hsetlik/EnvFilterPedal/Simulations/mc34063_sim.asc

C1: polcap; 220µ
C2: cap; 470p
C3: polcap; 470µ
C4: polcap; 220µ
D1: schottky; RB050LAM-30
L1: ind; 68µ
L2: ind; 4.7µ
R1: res; 0.24
R2: res; 8k2
R3: res; 51k
R4: res; 90
U2: mc34063
V2: battery; 9
Named nets: 0, -9a, -9b
.tran 40m startup
.inc mc34063.lib
