hsetlik/EnvFilterPedal/Simulations/LadderFilterSim.asc

C1: cap; 47n
C2: cap; 47n
C3: cap; 47n
C4: cap; 47n
C5: cap; 220µ
C6: polcap; 10µ
C7: cap; 10µ
C8: cap; 1µ
C9: cap; 22µ
Q1: npn; BC547B
Q2: npn; BC547B
Q3: npn; BC547B
Q4: npn; BC547B
Q5: npn; BC547B
Q6: npn; BC547B
Q7: npn; BC547B
Q8: npn; BC547B
Q9: npn; BC547B
Q10: npn; BC547B
Q11: npn; BC547B
Q12: pnp; BC557C
R1: res; 220
R2: res; 220
R3: res; 220
R4: res; 220
R5: res; 220
R6: res; 220
R7: res; 470
R8: res; 100k
R9: res; 100k
R10: res; 470
R11: res; 470k
R12: res; 470k
R13: res; 100k
R14: res; 100k
R15: res; 5k
R16: res; 5k
R17: res; 100k
R18: res; 100k
R19: res; 470k
R20: res; 1k
R21: res; 100k
R22: res; 100k
R23: res; 680
R24: res; 2k
R25: res; 8k
R26: res; 47k
R27: res; 470
R28: res; 1k8
R29: res; 100k
R30: res; 470k
R31: res; 22k
R32: res; 3k
R33: res; 7k
R34: res; 100k
U1: LT1058
U2: LT1058
U3: LT1058
U4: LT1058
U5: LT1058
U6: LT1058
V1: voltage; PULSE(-200mv 200mv 0 100u 100u 2m 4m)
V2: voltage; 9
V4: voltage; PULSE(3.3 0 500m 10m 60m 30m 100m 1)
Named nets: +9, 0, env, GTR, vg, b1, b2, b3, b4, b5
.tran 0 600m 500m
.lib lm13700.sub
R15 & 16 = 10k resonance control
NOTE: this is inverting to the env. attenuverter
should be wired in reverse to match
