hsetlik/EnvFilterPedal/Simulations/EnvFollowerRev2.asc

C1: cap; 470n
C2: cap; 4.7n
C3: cap; 1µ
C4: cap; 100n
C5: cap; 1µ
C6: cap; 10n
D1: diode; 1N4148
D2: diode; 1N4148
D3: diode; 1N4148
D4: LED
Q1: pnp; BC857A
Q2: pnp; BC857A
Q3: npn; BC847A
R1: res; 4.7k
R2: res; 100k
R3: res; 680
R4: res; 680
R5: res; 4.7k
R6: res; 91k
R7: res; 2k7
R8: res; 470k
R9: res; 22k
R10: res; 1Meg
R11: res; 100k
R12: res; 100k
R13: res; 100k
R14: res; 50k
R15: res; 1k
R16: res; 100k
R17: res; 22k
R18: res; 100k
R19: res; 100k
R20: res; 6k8
R21: res; 1k8
R28: res; 47k
R29: res; 12k
U1: LM13700
U2: LT1058
U3: LT1058
U4: LT1058
U5: LT1058
U6: LT1058
U7: LT1058
U8: LT1058
U11: LT1058
V1: voltage; SINE(0 0.1 440)
V2: voltage; 9
V3: voltage; 9
V4: voltage; PULSE(0 3.3 0 10m 60m 30m 100m 1)
V5: voltage; 5
Named nets: 0, +9, -9, GTR, vcc, GTR_GAIN, FullRect
.tran 200m UIC
.INCLUDE CD4000.lib
.INCLUDE 74HC.lib
.lib lm13700.sub
Ignore this it's just a convenient way to simulate a guitar signal
