hsetlik/EnvFilterPedal/Simulations/FilterType2.asc

C1: cap; 470n
C2: cap; 470n
C5: cap; 4.7n
C6: cap; 1n
C7: cap; 470n
C8: cap; 1n
C9: cap; 470n
C10: cap; 1n
C11: cap; 1n
C12: cap; 470n
C13: cap; 470n
D3: diode; 1N4148
D4: diode; 1N4148
Q3: pnp; BC857A
Q4: pnp; BC857A
R1: res; 47k
R2: res; 47k
R3: res; 50k
R4: res; 50k
R5: res; 33k
R6: res; 33k
R7: res; 100k
R8: res; 10k
R9: res; 10k
R10: res; 5k
R11: res; 5k
R22: res; 33k
R23: res; 680
R24: res; 680
R25: res; 4.7k
R26: res; 100k
R27: res; 2.2k
R28: res; 470k
R29: res; 33k
R30: res; 680
R31: res; 680
R32: res; 33k
R33: res; 33k
R34: res; 80k
R35: res; 20k
R36: res; 10k
R37: res; 1.8k
R38: res; 4.7k
R39: res; 4.7k
R40: res; 100k
R41: res; 7k
R42: res; 3k
R43: res; 22k
R44: res; 22k
R45: res; 680
R46: res; 680
R47: res; 33k
R48: res; 22k
R49: res; 4.7k
R53: res; 680
R54: res; 680
R55: res; 33k
R56: res; 22k
R57: res; 4.7k
U1: LT1058
U2: LT1058
U7: LM13700
U8: LT1058
U9: LM13700
U10: LM13700
U12: LT1058
U13: LM13700
V1: voltage; PULSE(-200mv 200mv 0 200u 200u 3m 6m)
V2: voltage; 9
V3: voltage; 9
V4: voltage; PULSE(0 3.3 20m 10m 60m 30m 100m 1)
Named nets: +9, -9, 0, env, GTR, ENV, LP_CONS, IABC, HP_CONS, SUM
.tran 200m UIC
.lib lm13700.sub
Ignore this it's just a convenient way to simulate a guitar signal
R41 & 42 = 10k frequency control
R3 & R4 = 100k blend control
R10 & 11 = 10k depth control
