hsetlik/EnvFilterPedal/Simulations/EnvFollowerSim.asc

C1: cap; 470n
C2: cap; 4.7n
C3: cap; 10n
C5: cap; 100n
C6: cap; 1µ
D9: diode; 1N4148
D10: diode; 1N4148
D11: diode; 1N4148
D12: diode; 1N4148
Q1: pnp; BC857A
Q2: pnp; BC857A
R1: res; 4.7k
R2: res; 100k
R3: res; 680
R4: res; 680
R5: res; 4.7k
R6: res; 91k
R7: res; 2k7
R8: res; 470k
R9: res; 22k
R10: res; 100k
R16: res; 22k
R17: res; 47k
R18: res; 470
R19: res; 50k
R20: res; 100k
R21: res; 100k
R22: res; 820
R27: res; 22k
R28: res; 100k
R29: res; 22k
U1: LM13700
U2: LT1058
U3: LT1058
U8: LT1058
U9: LT1058
U10: LT1058
U11: LT1058
V1: voltage; SINE(0 0.1 440)
V2: voltage; 9
V3: voltage; 9
V4: voltage; PULSE(0 3.3 0 10m 60m 30m 100m 1)
V5: voltage; 5
Named nets: 0, +9, -9, GTR, vcc
.tran 200m UIC
.INCLUDE CD4000.lib
.INCLUDE 74HC.lib
.lib lm13700.sub
Ignore this it's just a convenient way to simulate a guitar signal
R19 = Sustain control 100k
