hsetlik/EnvFilterPedal/EnvFilterPedal.kicad_pcb

## KiCad design EnvFilterPedal.kicad_pcb (2026-07-02)

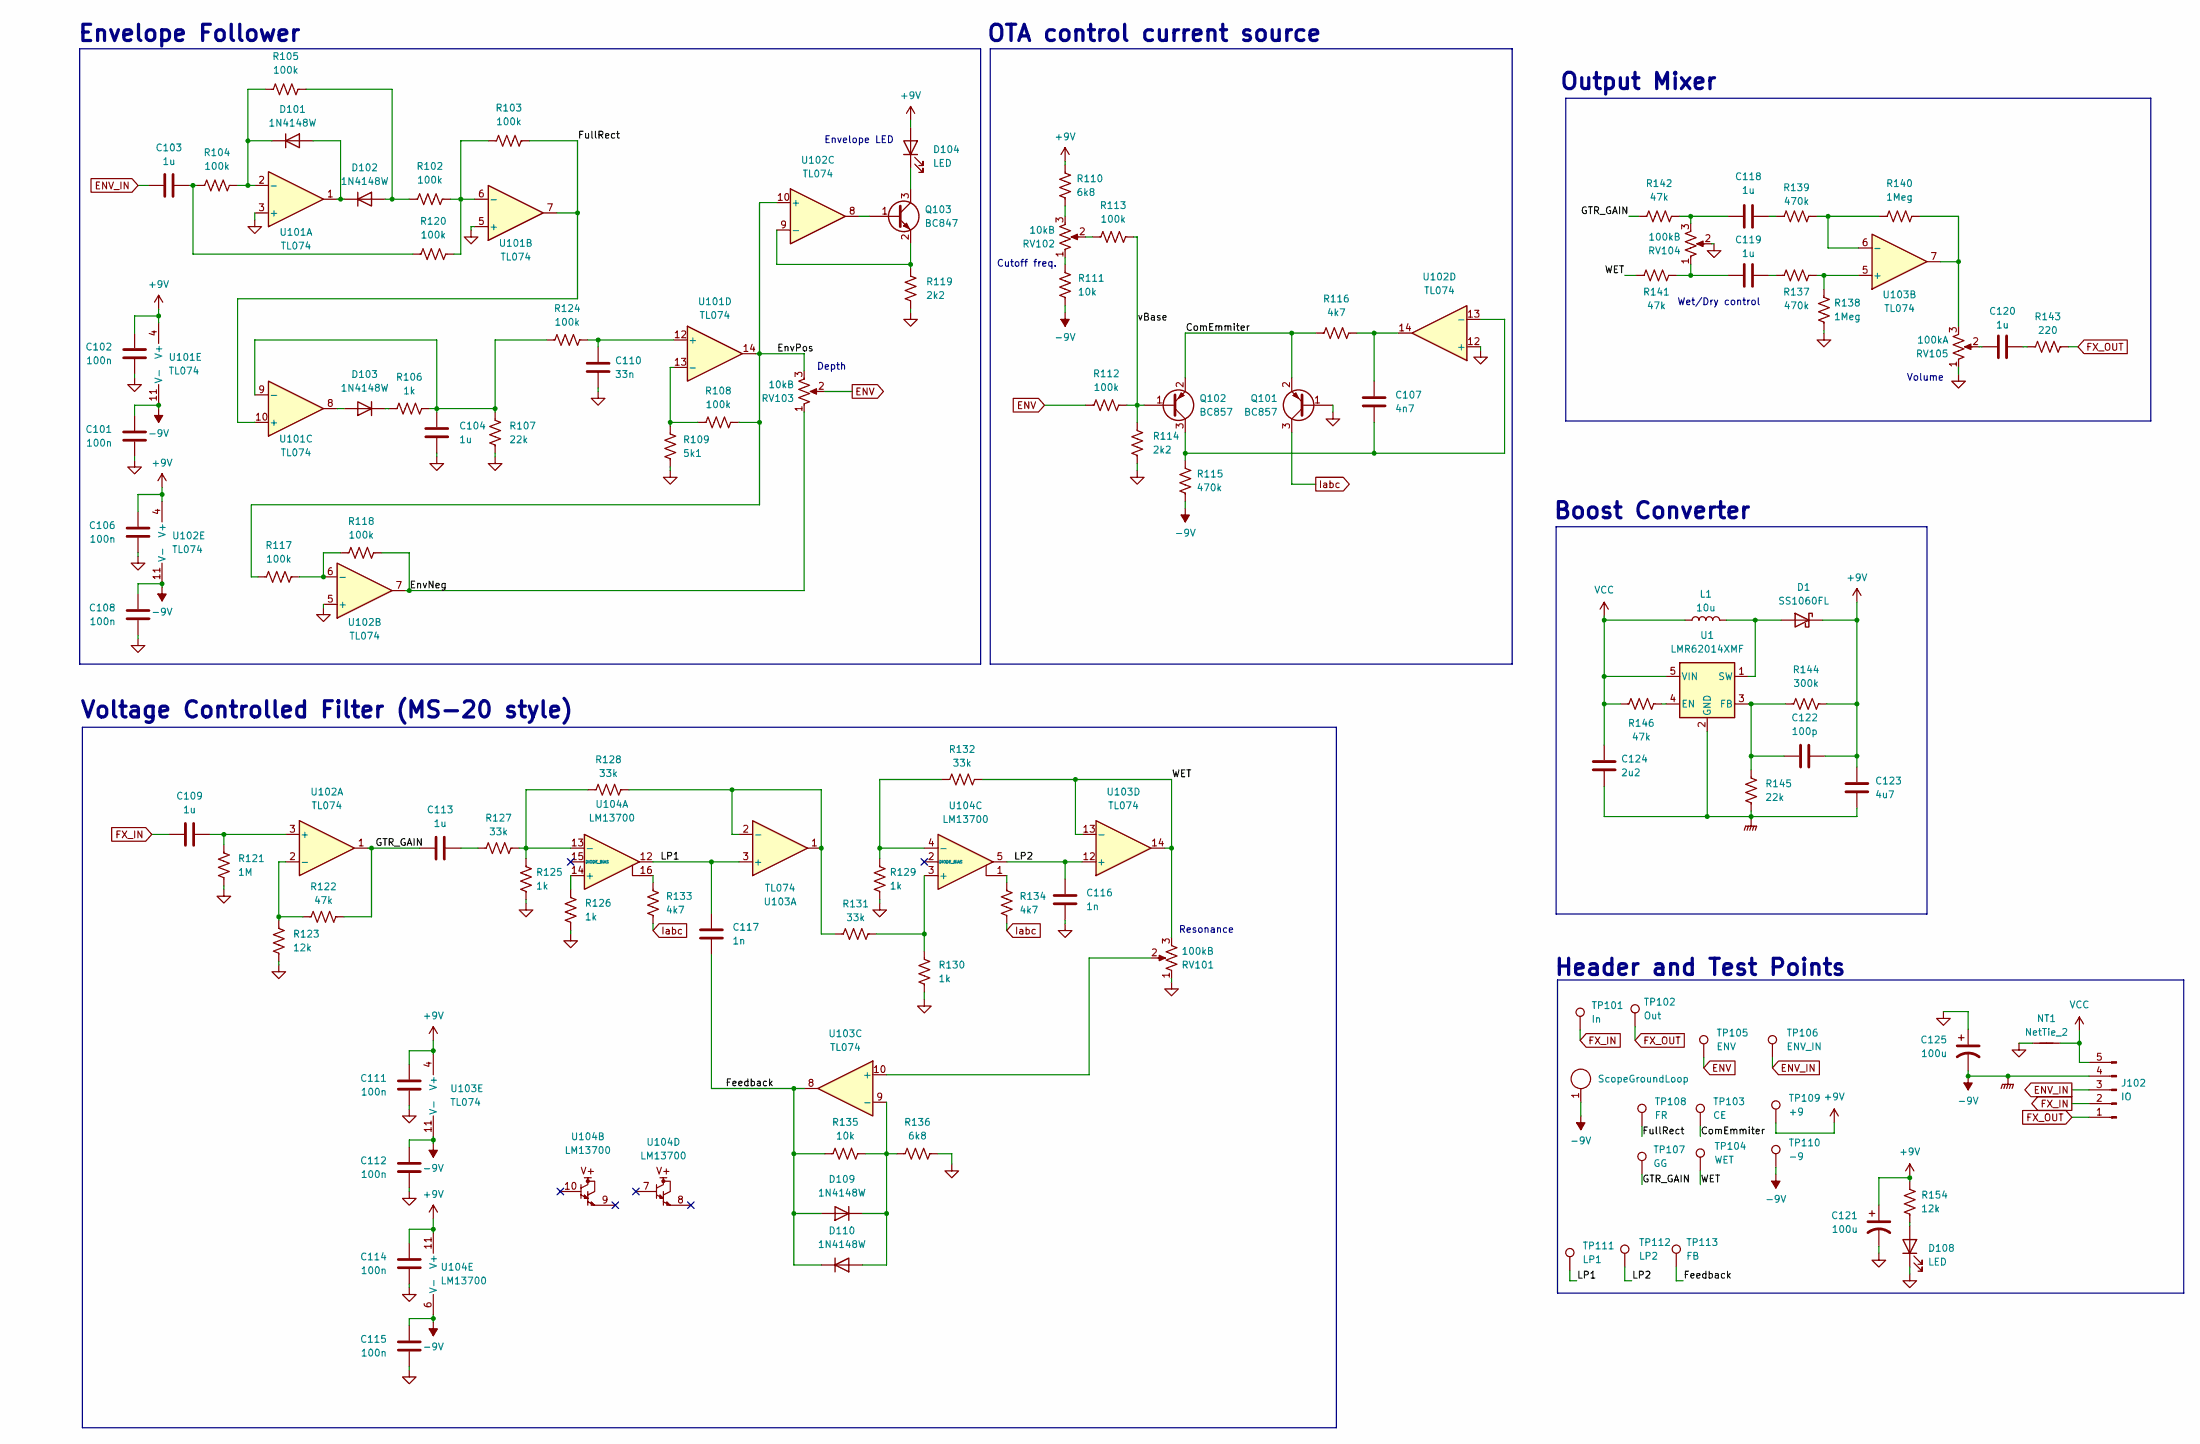
[picture p1: schematic EnvFilterPedal.kicad_sch]

Parts:
C101, C102, C106, C108, C111, C112, C114, C115: 100n; C_0805_2012Metric
C103, C104, C109, C113, C118, C119, C120: 1u; C_0805_2012Metric
C107: 4n7; C_0805_2012Metric
C110: 33n; C_0805_2012Metric
C116, C117: 1n; C_0805_2012Metric
C121, C125: 100u; CP_Radial_D5.0mm_P2.00mm
C122: 100p; C_0805_2012Metric
C123: 4u7; C_0805_2012Metric
C124: 2u2; C_0805_2012Metric
D1: SS1060FL; D_SOD-123F
D101, D102, D103, D109, D110: 1N4148W; D_SOD-123
D104, D108: LED; LED_D3.0mm
J101: ScopeGroundLoop; THT_GND_WIRE
J102: IO; PinHeader_1x05_P2.54mm_Vertical
L1: 10u; L_SigTransformer_SLPPI04_15
NT1: NetTie_2; NetTie-2_SMD_Pad0.5mm
Q101, Q102: BC857; SOT-23
Q103: BC847; SOT-23
R102, R103, R104, R105, R108, R112, R113, R117, R118, R120, R124: 100k; R_0805_2012Metric
R106, R125, R126, R129, R130: 1k; R_0805_2012Metric
R107, R145: 22k; R_0805_2012Metric
R109: 5k1; R_0805_2012Metric
R110, R136: 6k8; R_0805_2012Metric
R111, R135: 10k; R_0805_2012Metric
R114, R119: 2k2; R_0805_2012Metric
R115, R137, R139: 470k; R_0805_2012Metric
R116, R133, R134: 4k7; R_0805_2012Metric
R121: 1M; R_0805_2012Metric
R122, R141, R142, R146: 47k; R_0805_2012Metric
R123, R154: 12k; R_0805_2012Metric
R127, R128, R131, R132: 33k; R_0805_2012Metric
R138, R140: 1Meg; R_0805_2012Metric
R143: 220; R_0805_2012Metric
R144: 300k; R_0805_2012Metric
RV101, RV104: 100kB; Potentiometer_Alpha_RV16AF_42_VeryLong
RV102, RV103: 10kB; Potentiometer_Alpha_RV16AF_42_VeryLong
RV105: 100kA; Potentiometer_Alpha_RV16AF_42_VeryLong
TP101: In; TestPoint_THTPad_D2.0mm_Drill1.0mm_VAL
TP102: Out; TestPoint_THTPad_D2.0mm_Drill1.0mm_VAL
TP103: CE; TestPoint_THTPad_D2.0mm_Drill1.0mm_VAL
TP104: WET; TestPoint_THTPad_D2.0mm_Drill1.0mm_VAL
TP105: ENV; TestPoint_THTPad_D2.0mm_Drill1.0mm_VAL
TP106: ENV_IN; TestPoint_THTPad_D2.0mm_Drill1.0mm_VAL
TP107: GG; TestPoint_THTPad_D2.0mm_Drill1.0mm_VAL
TP108: FR; TestPoint_THTPad_D2.0mm_Drill1.0mm_VAL
TP109: +9; TestPoint_THTPad_D2.0mm_Drill1.0mm_VAL
TP110: -9; TestPoint_THTPad_D2.0mm_Drill1.0mm_VAL
TP111: LP1; TestPoint_THTPad_D2.0mm_Drill1.0mm_VAL
TP112: LP2; TestPoint_THTPad_D2.0mm_Drill1.0mm_VAL
TP113: FB; TestPoint_THTPad_D2.0mm_Drill1.0mm_VAL
U1: LMR62014XMF; SOT-23-5
U101, U102, U103: TL074; SOIC-14_3.9x8.7mm_P1.27mm
U104: LM13700; SOIC-16_3.9x9.9mm_P1.27mm

Connections:
+9V: C102.1, C106.1, C111.1, C114.1, C121.1, C122.2, C123.1, D1.1 (K), D104.2 (A), R110.1, R144.2, R154.1, TP109.1 (1_1), U101.4 (V+), U102.4 (V+), U103.4 (V+), U104.11 (V+)
-9V: C101.1, C108.1, C112.1, C115.1, C123.2, C124.2, C125.2, J101.1, J102.4, R111.2, R115.2, R145.1, TP110.1 (1_1), U1.2 (GND), U101.11 (V-), U102.11 (V-), U103.11 (V-), U104.6 (V-)
/ComEmmiter: Q101.2 (E), Q102.2 (E), R116.1, TP103.1 (1_1)
/EnvNeg: R118.2, RV103.1, U102.7
/EnvPos: R108.2, R117.1, RV103.3, U101.14, U102.10 (+)
/Feedback: C117.2, D109.2 (A), D110.1 (K), R135.1, TP113.1 (1_1), U103.8
/FullRect: R103.2, TP108.1 (1_1), U101.7, U101.10 (+)
/GTR_GAIN: C113.1, R122.2, R142.1, TP107.1 (1_1), U102.1
/LP1: C117.1, TP111.1 (1_1), U103.3 (+), U104.12
/LP2: C116.1, TP112.1 (1_1), U103.12 (+), U104.5
/WET: R132.2, R141.1, RV101.3, TP104.1 (1_1), U103.13 (-), U103.14
/vBase: Q102.1 (B), R112.2, R113.2, R114.1
ENV: R112.1, RV103.2, TP105.1 (1_1)
ENV_IN: C103.1, J102.3, TP106.1 (1_1)
FX_IN: C109.1, J102.2, TP101.1 (1_1)
FX_OUT: J102.1, R143.2, TP102.1 (1_1)
GND: C101.2, C102.2, C104.2, C106.2, C108.2, C110.2, C111.2, C112.2, C114.2, C115.2, C116.2, C121.2, C125.1, D108.1 (K), NT1.1, Q101.1 (B), R107.2, R109.2, R114.2, R119.2, R121.2, R123.2, R125.1, R126.1, R129.1, R130.1, R136.1, R138.2, RV101.1, RV104.2, RV105.1, U101.3 (+), U101.5 (+), U102.5 (+), U102.12 (+)
Iabc: Q101.3 (C), R133.1, R134.1
unnamed: C103.2, R104.1, R120.1
unnamed: C107.1, R116.2, U102.14
unnamed: C113.2, R127.1
unnamed: C118.1, R142.2, RV104.3
unnamed: C118.2, R139.1
unnamed: C119.1, R141.2, RV104.1
unnamed: C119.2, R137.1
unnamed: C120.1, R143.1
unnamed: C120.2, RV105.2
unnamed: D1.2 (A), L1.2, U1.1 (SW)
unnamed: D101.2 (A), D102.1 (K), U101.1
unnamed: D101.1 (K), R104.2, R105.1, U101.2 (-)
unnamed: D102.2 (A), R102.1, R105.2
unnamed: D103.2 (A), U101.8
unnamed: D103.1 (K), R106.1
unnamed: D104.1 (K), Q103.3 (C)
unnamed: D108.2 (A), R154.2
unnamed: D109.1 (K), D110.2 (A), R135.2, R136.2, U103.9 (-)
unnamed: C107.2, Q102.3 (C), R115.1, U102.13 (-)
unnamed: Q103.1 (B), U102.8
unnamed: Q103.2 (E), R119.1, U102.9 (-)
unnamed: R110.2, RV102.3
unnamed: R111.1, RV102.1
unnamed: R113.1, RV102.2
unnamed: R133.2, U104.16
unnamed: R134.2, U104.1
unnamed: R140.2, RV105.3, U103.7
unnamed: R146.2, U1.4 (EN)
unnamed: C122.1, R144.1, R145.2, U1.3 (FB)
unnamed: R102.2, R103.1, R120.2, U101.6 (-)
unnamed: C104.1, R106.2, R107.1, R124.1, U101.9 (-)
unnamed: C110.1, R124.2, U101.12 (+)
unnamed: R108.1, R109.1, U101.13 (-)
unnamed: C109.2, R121.1, U102.3 (+)
unnamed: R122.1, R123.1, U102.2 (-)
unnamed: R117.2, R118.1, U102.6 (-)
unnamed: R128.2, R131.1, U103.1, U103.2 (-)
unnamed: R137.2, R138.1, U103.5 (+)
unnamed: R139.2, R140.1, U103.6 (-)
unnamed: RV101.2, U103.10 (+)
unnamed: R126.2, U104.14 (+)
unnamed: R125.2, R127.2, R128.1, U104.13 (-)
unnamed: R130.2, R131.2, U104.3 (+)
unnamed: R129.2, R132.1, U104.4 (-)
VCC: C124.1, J102.5, L1.1, NT1.2, R146.1, U1.5 (VIN)

Notes on the sheet:
Volume
Depth
Cutoff freq.
Boost Converter
Envelope Follower
Output Mixer
Resonance
Wet/Dry control
Header and Test Points
Envelope LED
Voltage Controlled Filter (MS-20 style)
OTA control current source

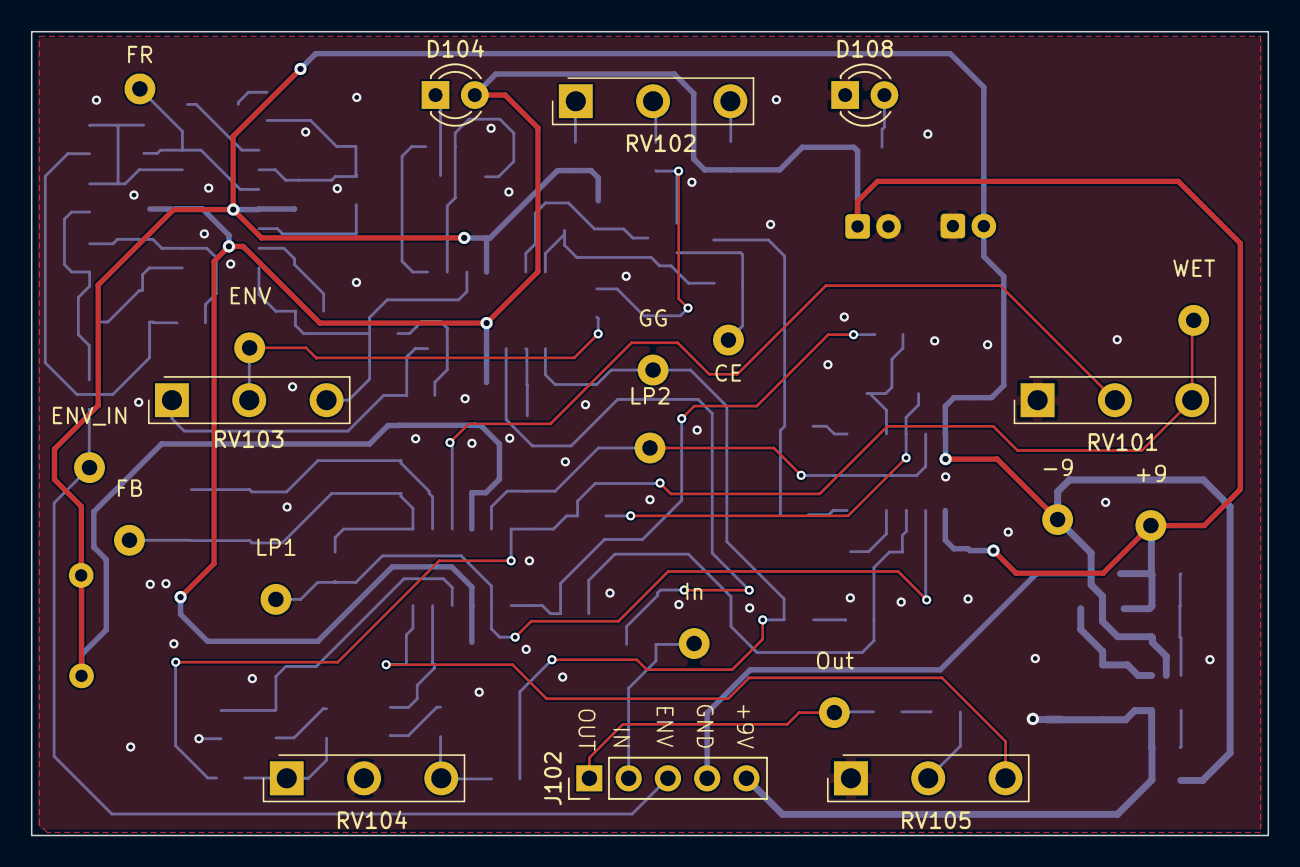
[picture p2: board EnvFilterPedal.kicad_pcb from above]

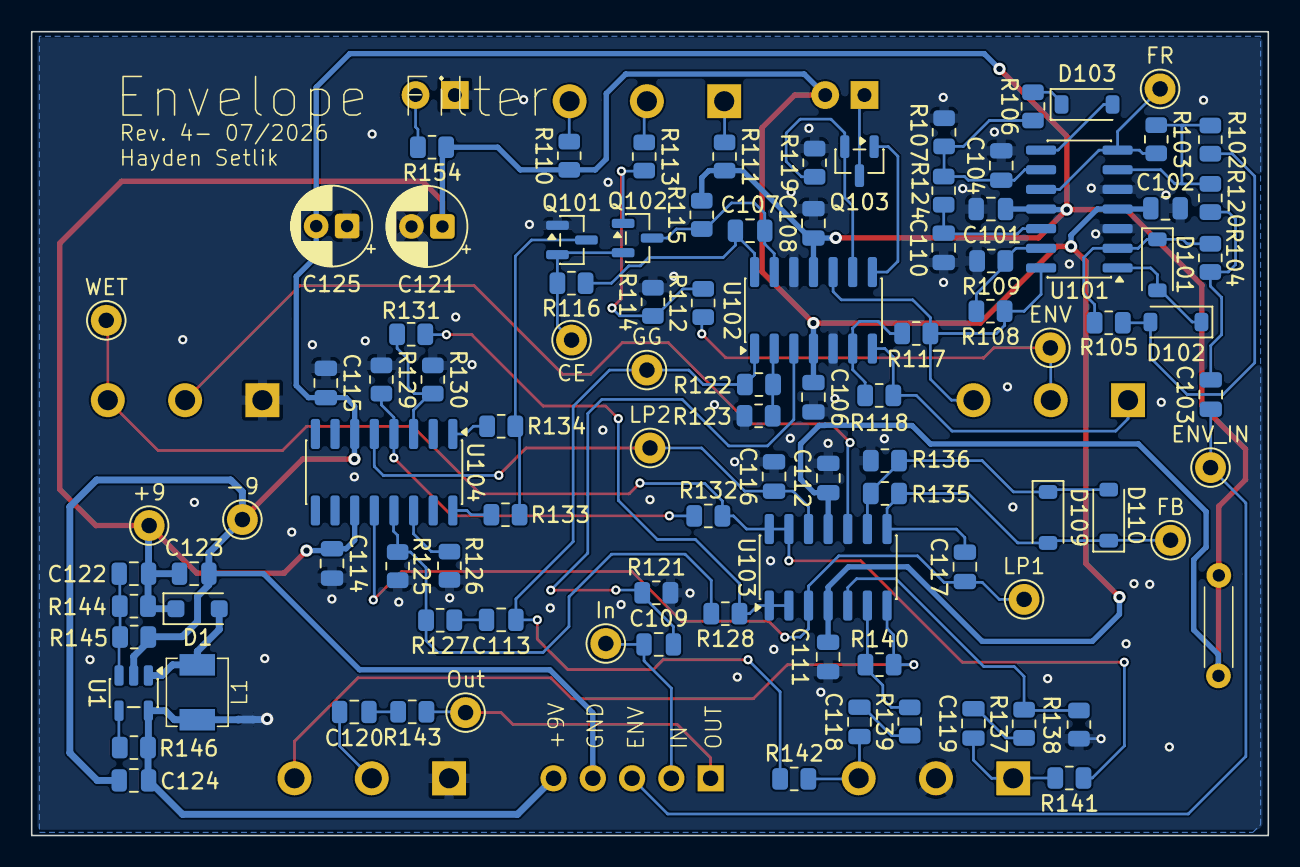
[picture p3: board EnvFilterPedal.kicad_pcb from below]

Board: 4 copper layers, 80.0 x 52.0 mm, 108 parts (100 on the bottom side), 63 nets.
