hsetlik/EnvFilterPedal/(commit log)

2024-12-23 schem and simulation for env follower
    [EnvFilterPedal.kicad_sch]
2024-12-24 schematic 1st pass
    [EnvFilterPedal.kicad_sch]
2024-12-24 footprints assigned
    [EnvFilterPedal.kicad_sch]
2025-01-10 rev 1 gerber
    [EnvFilterPedal.kicad_pcb, EnvFilterPedal.kicad_sch]
2025-01-18 filter value tweaks
    [EnvFilterPedal.kicad_sch]
2025-01-19 rev2 simulation stuff
    [EnvFilterPedal.kicad_pcb, EnvFilterPedal.kicad_sch]
2025-01-19 rev2 schematic and footprints
    [EnvFilterPedal.kicad_sch]
2025-01-20 4 layer layout
    [EnvFilterPedal.kicad_pcb, EnvFilterPedal.kicad_sch]
2025-01-20 routed, DRC passing
    [EnvFilterPedal.kicad_pcb]
2025-01-21 MCU pinout schematic
    [EnvFilterPedal.kicad_pcb]
2025-01-21 cleaned up routing
    [EnvFilterPedal.kicad_pcb]
2025-01-24 rev2 gerber
    [EnvFilterPedal.kicad_pcb, EnvFilterPedal.kicad_sch]
2025-01-24 added BOM
    [EnvFilterPedal.kicad_pcb]
2025-01-24 enclosure SVG files
    [EnvFilterPedal.kicad_pcb]
2025-01-28 simulation for single supply ladder filter
2025-01-28 discrete current source sim
2025-02-07 component tweaks after playing thru it for a day
    [EnvFilterPedal.kicad_pcb, EnvFilterPedal.kicad_sch]
2025-02-07 minor value tweaks
    [EnvFilterPedal.kicad_pcb, EnvFilterPedal.kicad_sch]
2025-02-12 added SMPS input filtering
    [EnvFilterPedal.kicad_pcb, EnvFilterPedal.kicad_sch]
2025-02-12 rev3 sent to fab
    [EnvFilterPedal.kicad_pcb]
2026-03-10 switched to 1u inductor on SMPS output
    [EnvFilterPedal.kicad_sch]
2026-03-10 laid out new inductor, some trace cleanup
    [EnvFilterPedal.kicad_pcb]
2026-03-14 vaues for LC power filter
2026-03-15 new layout
    [EnvFilterPedal.kicad_pcb, EnvFilterPedal.kicad_sch]
2026-03-16 stitching vias, minor layout changes
    [EnvFilterPedal.kicad_pcb]
2026-03-16 rev4 sent to fab
    [EnvFilterPedal.kicad_pcb]
2026-07-02 rev5 routed & drc passing
    [EnvFilterPedal.kicad_pcb, EnvFilterPedal.kicad_sch, EnvFilterSimulation.kicad_pcb, EnvFilterSimulation.kicad_sch]
